spietari18/Elelabra/liitteet/ad-muunnos/ad-muunnos.jpg

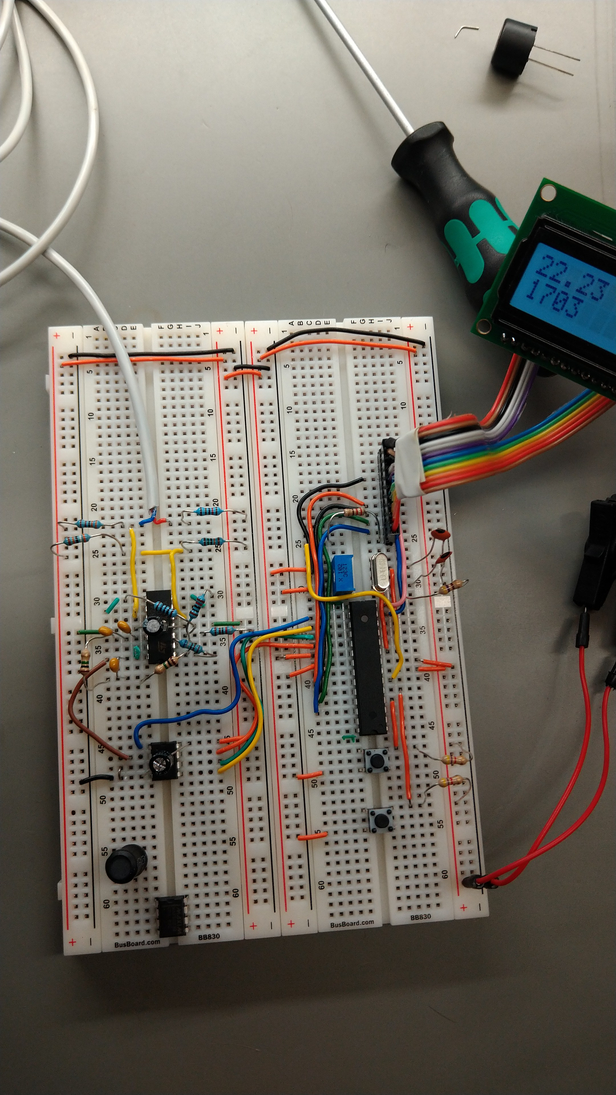
liitteet/ad-muunnos/ad-muunnos.jpg
