spietari18/Elelabra/README.md

## BL50A0503 - Elektroniikan laboratoriotyöt 1
