spietari18/Elelabra/liitteet/README.md

# Liitteet
## Mikrokontrollerin Käyttöönotto
- `käyttöönotto.c`: Lähdekoodi.
- `käyttöönotto.mp4`: Video toiminnasta.
- `vahvistin_lasku.rtf`: Vahvistinkytkennän lasku.
## AD-Muunnos
- `ad-muunnos.jpg`: Kuva toiminnasta.
- [Lähdekoodi kuvaushetkellä.](https://github.com/spietari18/Elelabra/tree/b525ab2afac167e4a86e1861a309233f2171b914/arduino/src)
## Käyttöliittymä
- `käyttöliittymä.mp4`: Video toiminnasta.
- [Lähdekoodi kuvaushetkellä.](https://github.com/spietari18/Elelabra/tree/88761098de45f244a9950bb6323d316a39081532/arduino/src)
