spietari18/Elelabra/liitteet/käyttöönotto/vahvistin_lasku.rtf

Sisääntulojännite:

Anturin resistanssit minimi- ja maksimilämpötilassa (-50°C,+80°C):

Wheatstone sillan resistanssit:

Differentiaalivahvistimen (puskuroidut) tulojännitteet:

Käytännön maksimi- ja minimilähtö operaatiovahvistimelle:

Differentiaalivahvistimen lähtö:

Kaksi resistanssia tulee määritellä, jotta toiset kaksi voidaan ratkaista:

Nämä saadaan differentiaalivahvistimen kaavasta:

Resistansseiksi saadaan siis:

Hylätään negatiiviset ratkaisut. Etsityt resistanssit ovat siis:
