spietari18/Elelabra/kicad/flow_chart/flow_chart.png

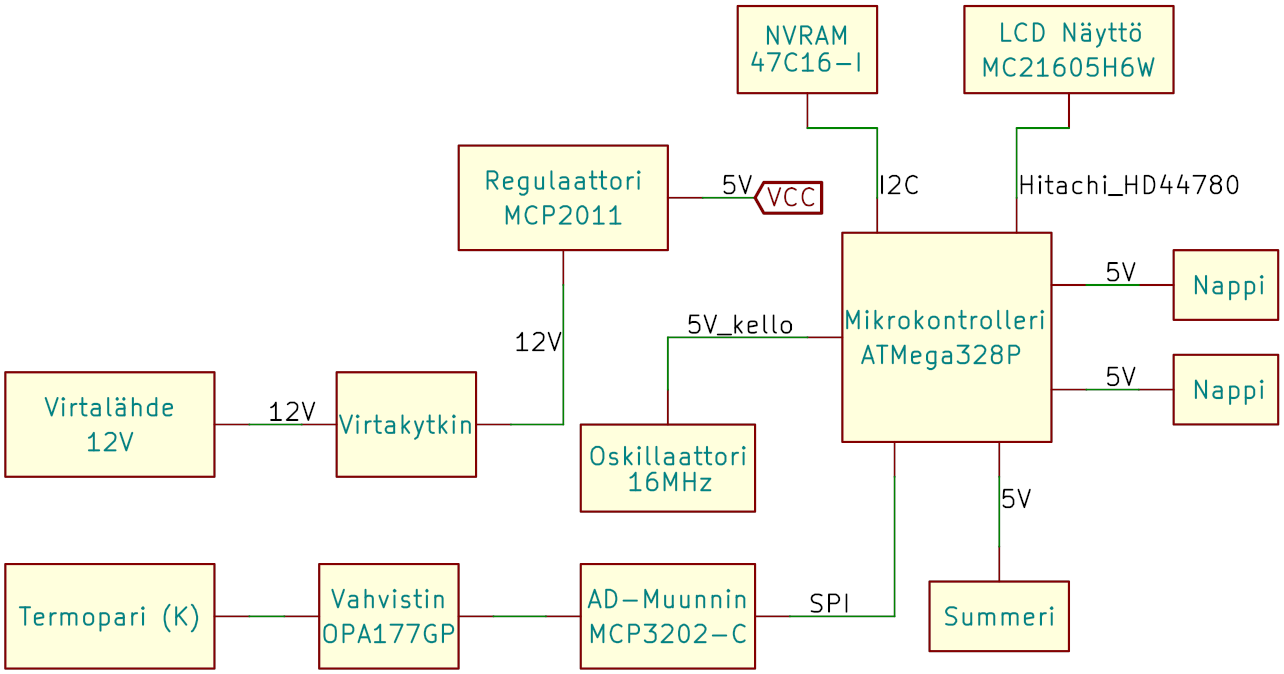
kicad/flow_chart/flow_chart.png
