spietari18/Elelabra/kicad/mikrokontrolleri/mikrokontrolleri.png

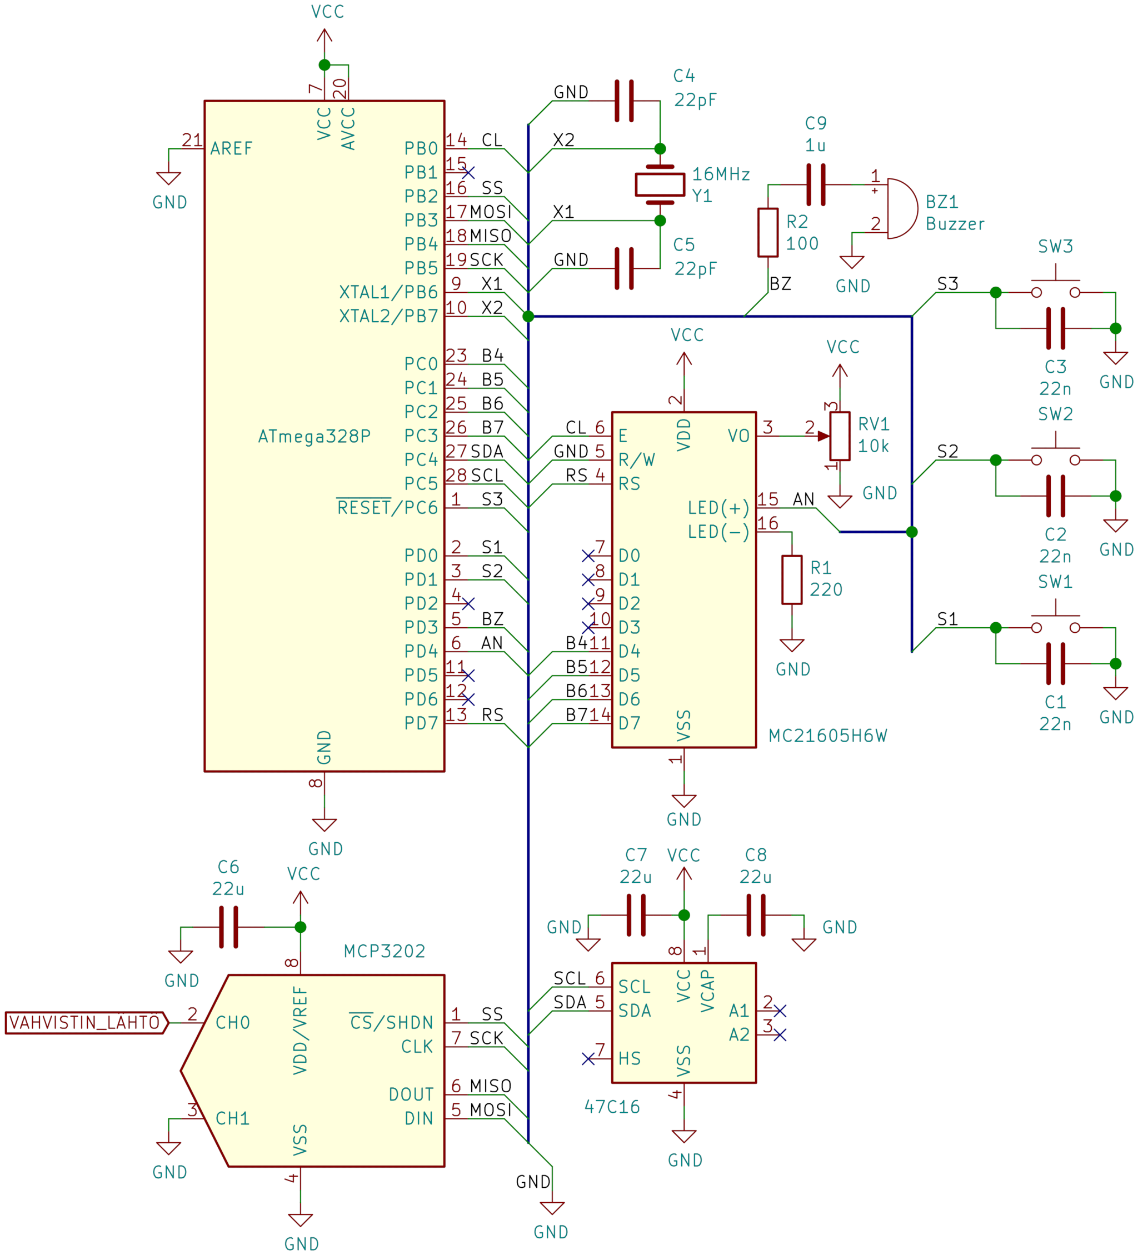
kicad/mikrokontrolleri/mikrokontrolleri.png
