spietari18/Elelabra/kicad/piirilevy/kuvat+cnc/back.png

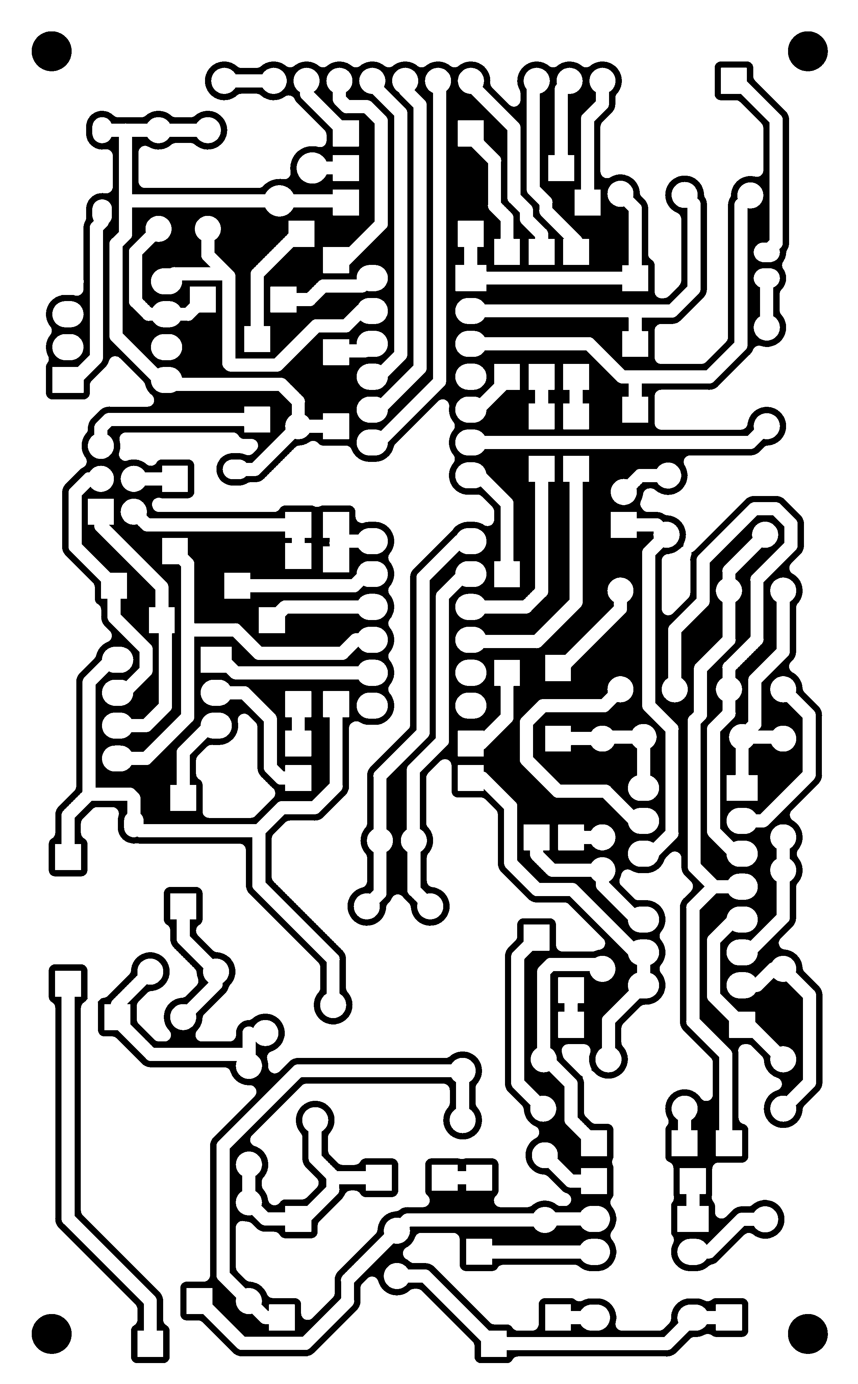
kicad/piirilevy/kuvat+cnc/back.png
