spietari18/Elelabra/kicad/piirilevy/kuvat+cnc/edges.png

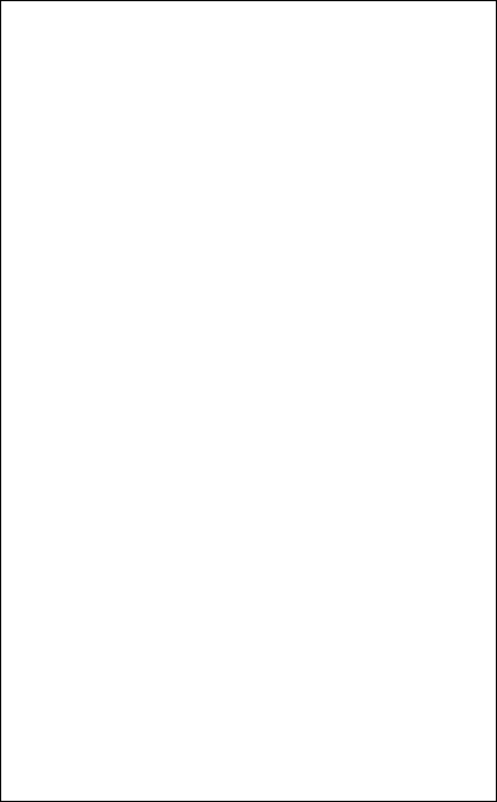
kicad/piirilevy/kuvat+cnc/edges.png
