spietari18/Elelabra/kicad/piirilevy/kuvat+cnc/holes.png

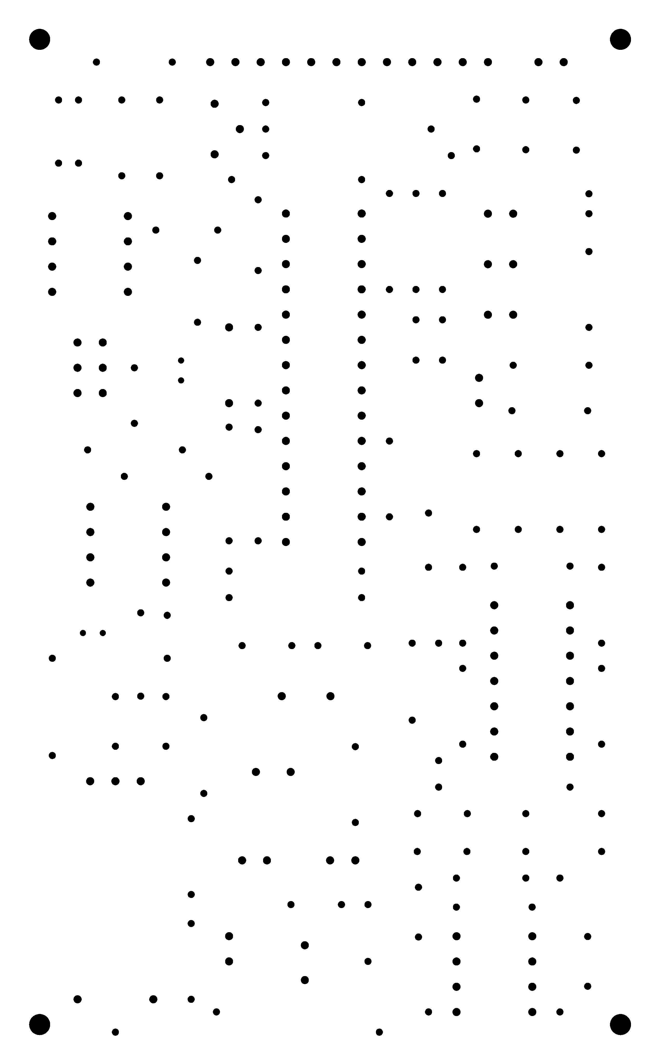
kicad/piirilevy/kuvat+cnc/holes.png
