spietari18/Elelabra/kicad/piirilevy/kuvat+cnc/render.png

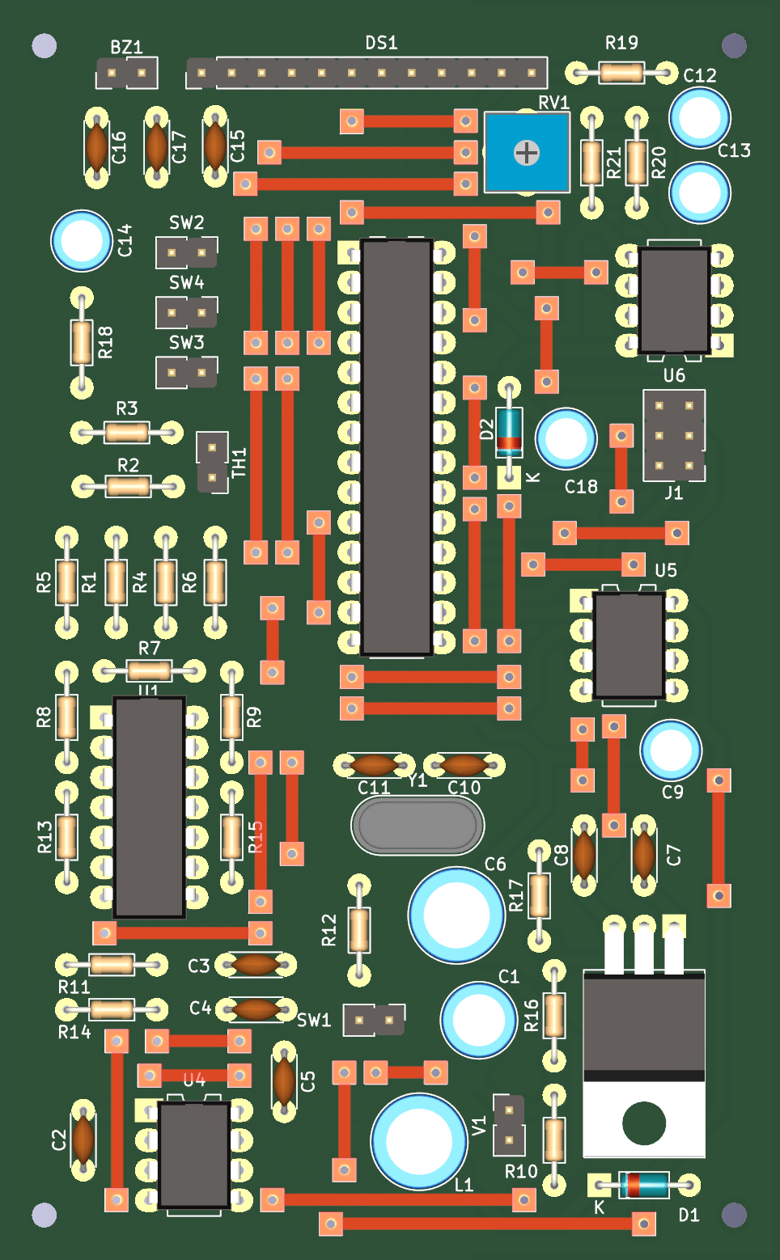
kicad/piirilevy/kuvat+cnc/render.png
