spietari18/Elelabra/kicad/regulaattori/regulaattori.png

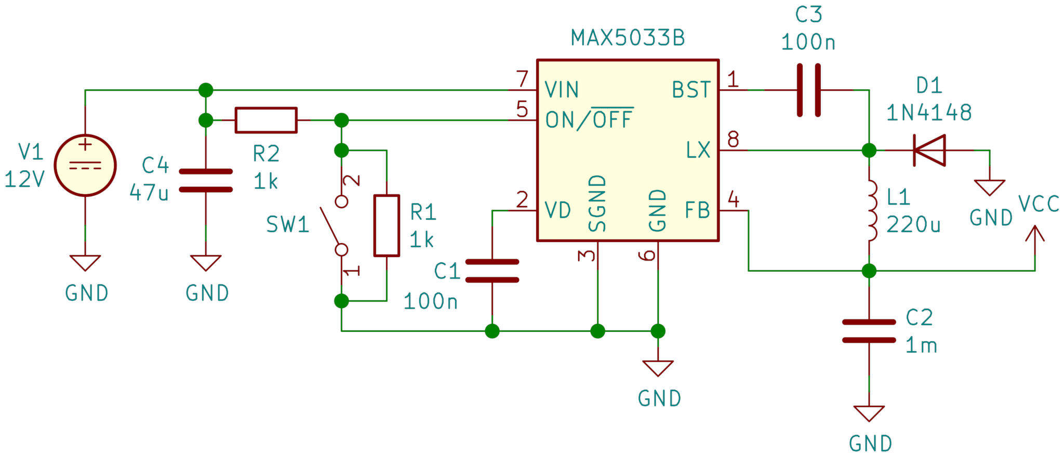
kicad/regulaattori/regulaattori.png
