spietari18/Elelabra/kicad/vahvistin/vahvistin.png

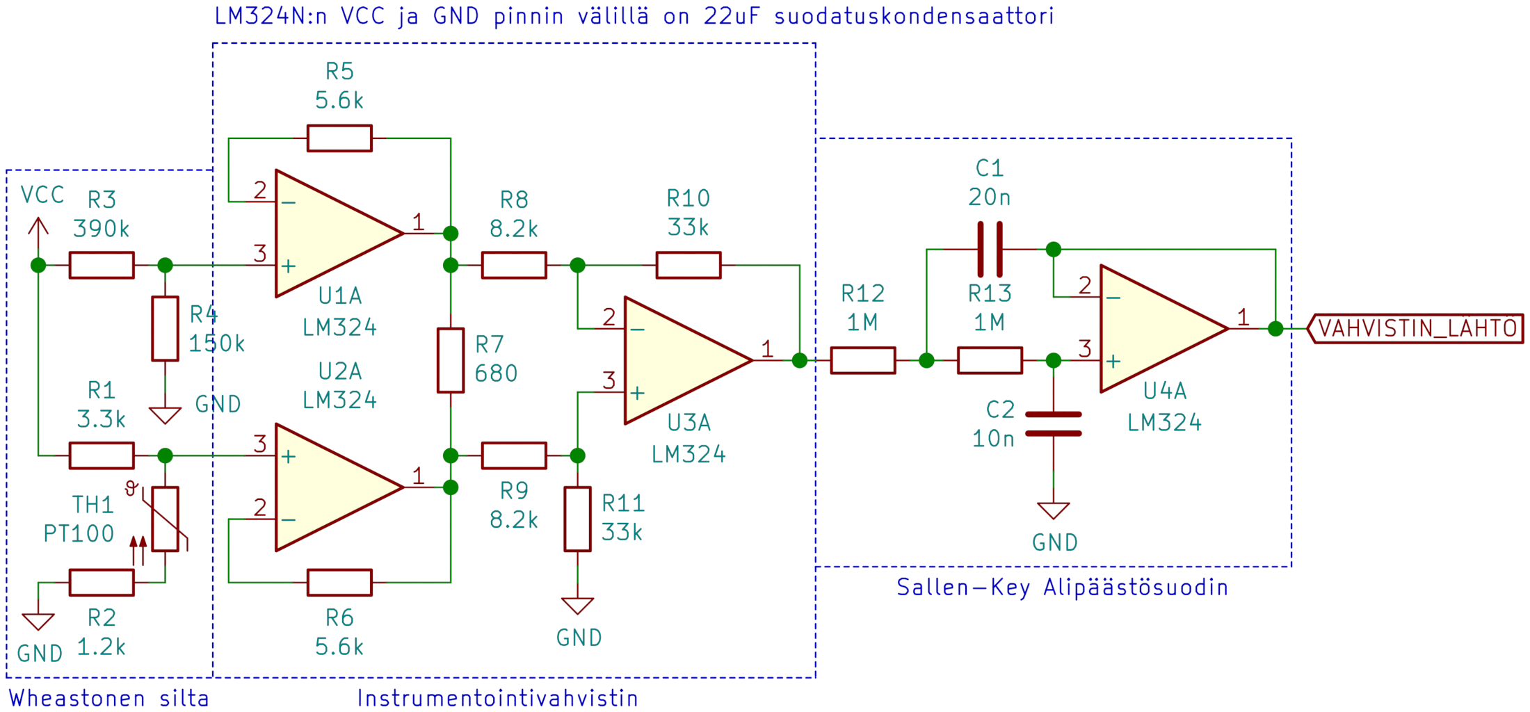
kicad/vahvistin/vahvistin.png
