spietari18/Elelabra/kicad/vahvistin/vahvistin_alpha.png

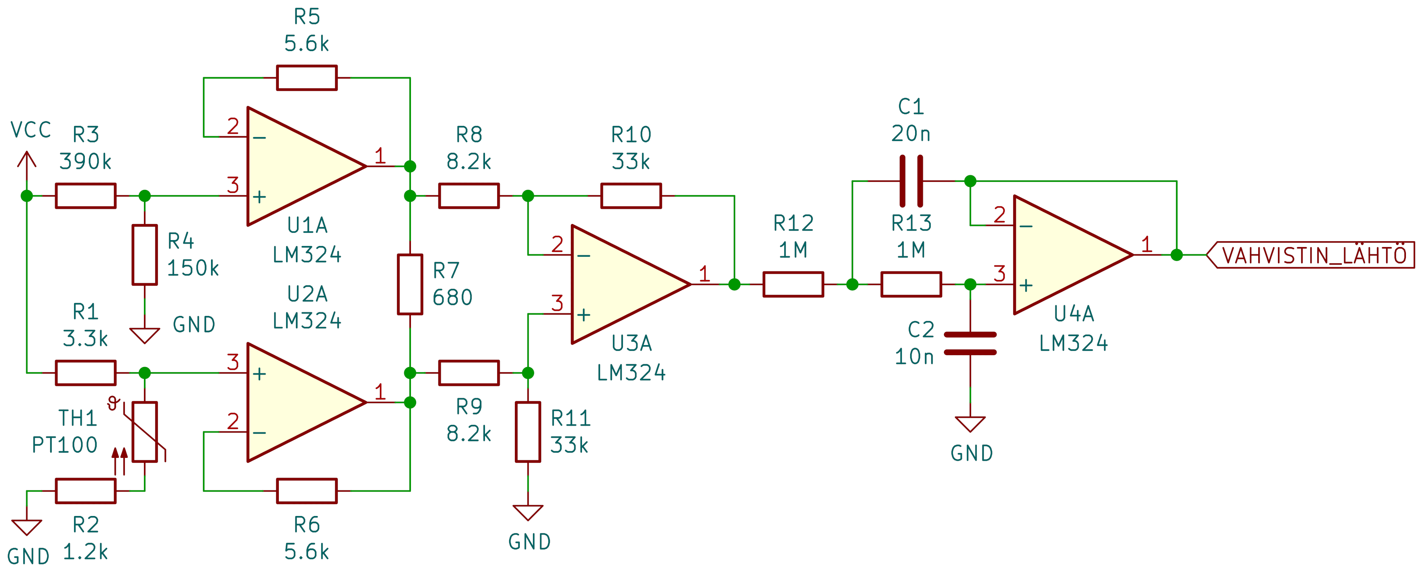
kicad/vahvistin/vahvistin_alpha.png
