spietari18/Elelabra/(list of files, drawings)

Other design files:
kicad/piirilevy/piirilevy.dsn
