spietari18/Elelabra/kicad/piirilevy/piirilevy.kicad_pcb

## KiCad design kicad/piirilevy/piirilevy.kicad_pcb (2022-03-16)

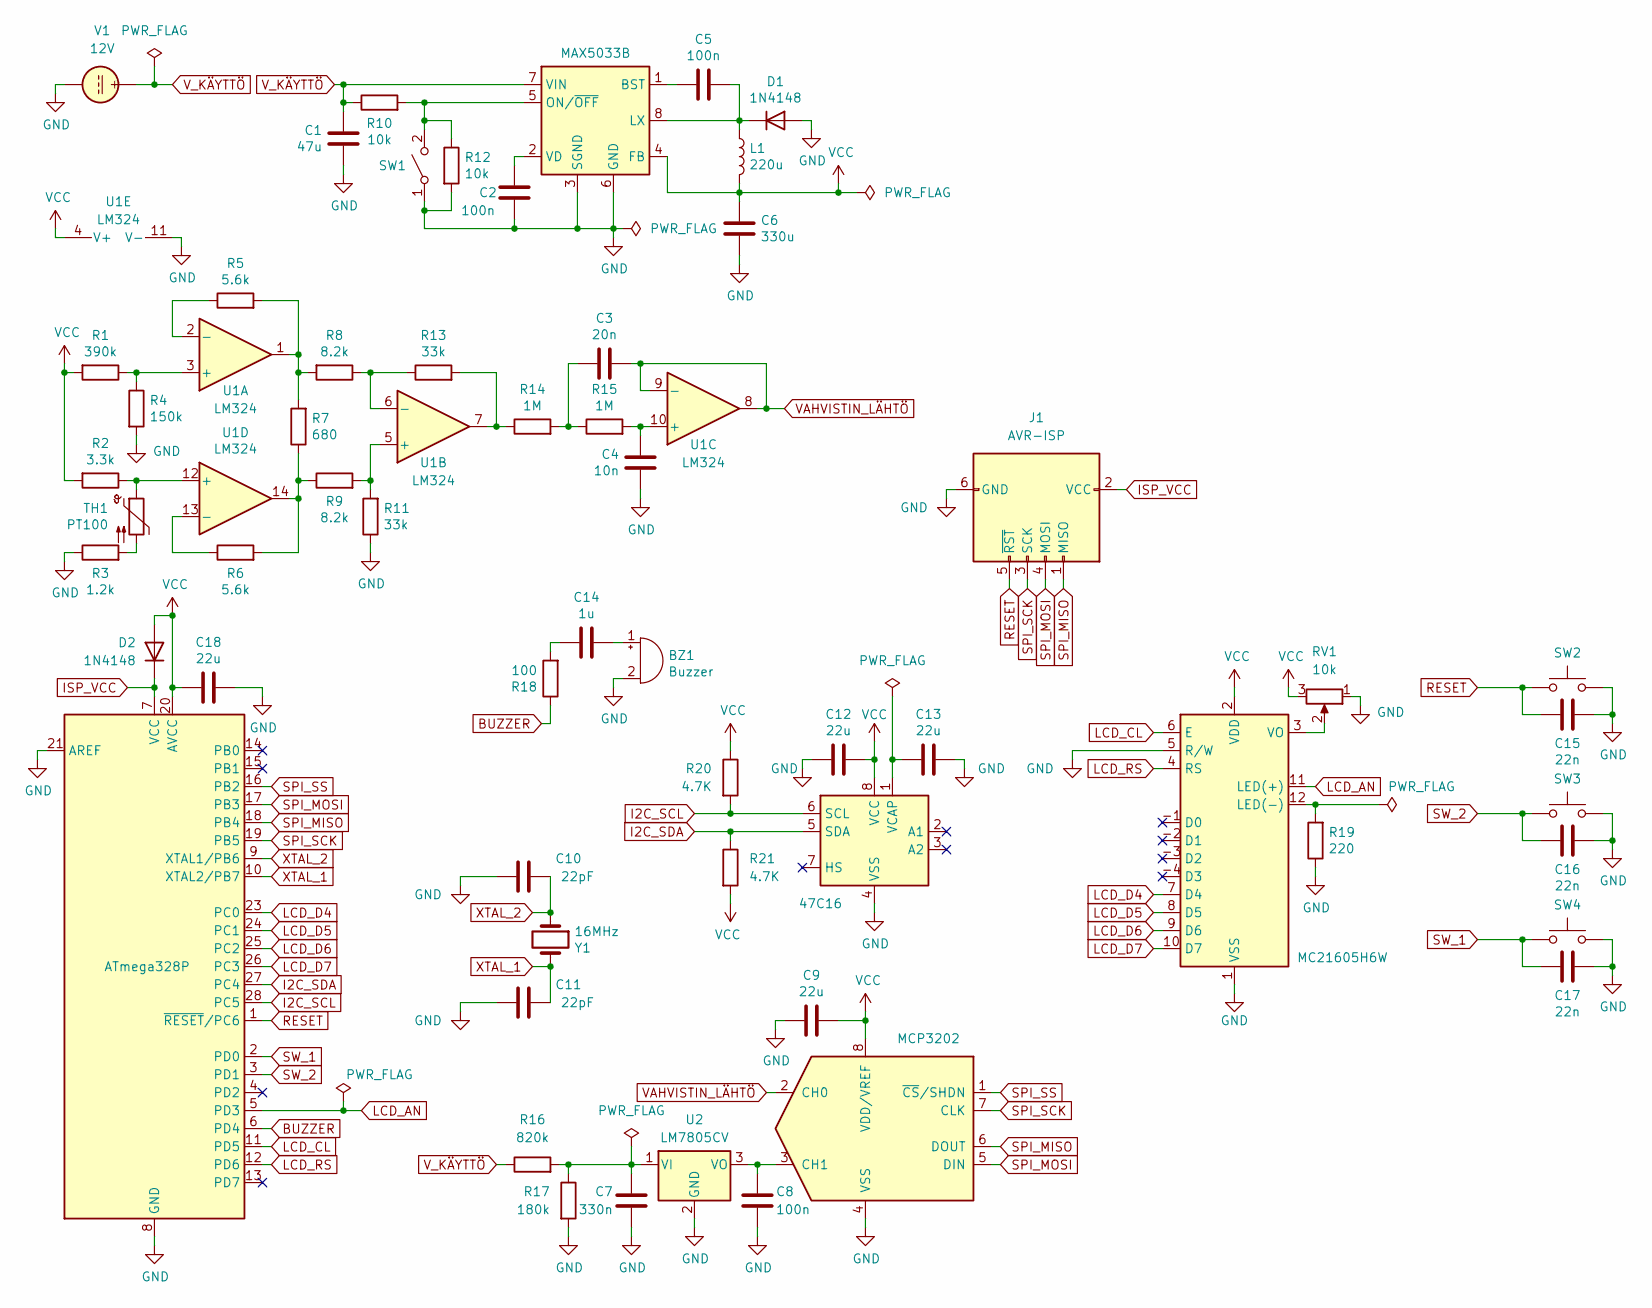
[picture p11: schematic piirilevy.kicad_sch]

Parts:
BZ1: Buzzer; PinHeader_1x02_P2.54mm_Vertical
C1: 47u; C_Radial_D6.3mm_H5.0mm_P2.50mm
C2, C5, C8: 100n; C_Disc_D4.3mm_W1.9mm_P5.00mm
C3: 20n; C_Disc_D4.3mm_W1.9mm_P5.00mm
C4: 10n; C_Disc_D4.3mm_W1.9mm_P5.00mm
C6: 330u; C_Radial_D8.0mm_H7.0mm_P3.50mm
C7: 330n; C_Disc_D4.3mm_W1.9mm_P5.00mm
C9, C18: 22u; C_Radial_D5.0mm_H7.0mm_P2.00mm
C10, C11: 22pF; C_Disc_D4.3mm_W1.9mm_P5.00mm
C12, C13: 22u; C_Radial_D5.0mm_H5.0mm_P2.00mm
C14: 1u; C_Radial_D5.0mm_H5.0mm_P2.00mm
C15, C16, C17: 22n; C_Disc_D4.3mm_W1.9mm_P5.00mm
D1, D2: 1N4148; D_DO-35_SOD27_P7.62mm_Horizontal
DS1: MC21605H6W; PinHeader_1x12_P2.54mm_Vertical
J1: AVR-ISP; PinHeader_2x03_P2.54mm_Vertical
L1: 220u; C_Radial_D8.0mm_H7.0mm_P3.50mm
R1: 390k; R_Axial_DIN0204_L3.6mm_D1.6mm_P7.62mm_Horizontal
R2: 3.3k; R_Axial_DIN0204_L3.6mm_D1.6mm_P7.62mm_Horizontal
R3: 1.2k; R_Axial_DIN0204_L3.6mm_D1.6mm_P7.62mm_Horizontal
R4: 150k; R_Axial_DIN0204_L3.6mm_D1.6mm_P7.62mm_Horizontal
R5, R6: 5.6k; R_Axial_DIN0204_L3.6mm_D1.6mm_P7.62mm_Horizontal
R7: 680; R_Axial_DIN0204_L3.6mm_D1.6mm_P7.62mm_Horizontal
R8, R9: 8.2k; R_Axial_DIN0204_L3.6mm_D1.6mm_P7.62mm_Horizontal
R10, R12: 10k; R_Axial_DIN0204_L3.6mm_D1.6mm_P7.62mm_Horizontal
R11, R13: 33k; R_Axial_DIN0204_L3.6mm_D1.6mm_P7.62mm_Horizontal
R14, R15: 1M; R_Axial_DIN0204_L3.6mm_D1.6mm_P7.62mm_Horizontal
R16: 820k; R_Axial_DIN0204_L3.6mm_D1.6mm_P7.62mm_Horizontal
R17: 180k; R_Axial_DIN0204_L3.6mm_D1.6mm_P7.62mm_Horizontal
R18: 100; R_Axial_DIN0204_L3.6mm_D1.6mm_P7.62mm_Horizontal
R19: 220; R_Axial_DIN0204_L3.6mm_D1.6mm_P7.62mm_Horizontal
R20, R21: 4.7K; R_Axial_DIN0204_L3.6mm_D1.6mm_P7.62mm_Horizontal
RV1: 10k; Potentiometer_Vishay_T73YP_Vertical
SW1: SW_SPST; PinHeader_1x02_P2.54mm_Vertical
SW2, SW3, SW4: SW_Push; PinHeader_1x02_P2.54mm_Vertical
TH1: PT100; PinHeader_1x02_P2.54mm_Vertical
U1: LM324; DIP-14_W7.62mm_LongPads
U2: LM7805CV; TO-220-3_Horizontal_TabDown
U3: ATmega328P; DIP-28_W7.62mm_LongPads
U4: MAX5033B; DIP-8_W7.62mm_LongPads
U5: MCP3202; DIP-8_W7.62mm_LongPads
U6: 47C16; DIP-8_W7.62mm_LongPads
V1: 12V; PinHeader_1x02_P2.54mm_Vertical
Y1: 16MHz; Crystal_HC18-U_Vertical

Connections:
BUZZER: R18.1, U3.6 (PD4)
GND: BZ1.2 (+), C1.1, C2.2, C4.2, C6.2, C7.2, C8.2, C9.2, C10.1, C11.2, C12.2, C13.1, C15.1, C16.1, C17.1, C18.1, D1.2 (A), DS1.1 (VSS), DS1.5 (R/W), J1.6 (GND), R3.1, R4.2, R11.1, R12.2, R17.2, R19.1, RV1.1, SW1.1 (A), SW2.2, SW3.2, SW4.2, U1.11 (V-), U2.2 (GND), U3.8 (GND), U3.21 (AREF), U3.22 (GND), U4.3 (SGND), U4.6 (GND), U5.4 (VSS), U6.4 (VSS), V1.2
I2C_SCL: R20.2, U3.28 (PC5), U6.6 (SCL)
I2C_SDA: R21.1, U3.27 (PC4), U6.5 (SDA)
ISP_VCC: D2.1 (K), J1.2 (VCC), U3.7 (VCC)
LCD_AN: DS1.11 (LED(+)), U3.5 (PD3)
LCD_CL: DS1.6 (E), U3.11 (PD5)
LCD_D4: DS1.7 (D4), U3.23 (PC0)
LCD_D5: DS1.8 (D5), U3.24 (PC1)
LCD_D6: DS1.9 (D6), U3.25 (PC2)
LCD_D7: DS1.10 (D7), U3.26 (PC3)
LCD_RS: DS1.4 (RS), U3.12 (PD6)
unnamed: BZ1.1 (-), C14.2
unnamed: C2.1, U4.2 (VD)
unnamed: C3.1, R14.2, R15.1
unnamed: C4.1, R15.2, U1.10 (+)
unnamed: C5.1, D1.1 (K), L1.1, U4.8 (LX)
unnamed: C5.2, U4.1 (BST)
unnamed: C7.1, R16.2, R17.1, U2.1 (VI)
unnamed: C8.1, U2.3 (VO), U5.3 (CH1)
unnamed: C13.2, U6.1 (VCAP)
unnamed: C14.1, R18.2
unnamed: DS1.3 (VO), RV1.2
unnamed: DS1.12 (LED(-)), R19.2
unnamed: R1.1, R4.1, U1.3 (+)
unnamed: R2.1, TH1.1, U1.12 (+)
unnamed: R3.2, TH1.2
unnamed: R5.1, U1.2 (-)
unnamed: R5.2, R7.2, R8.2, U1.1
unnamed: R6.1, U1.13 (-)
unnamed: R6.2, R7.1, R9.1, U1.14
unnamed: R10.2, R12.1, SW1.2 (B), U4.5 (ON/~OFF)
unnamed: R9.2, R11.2, U1.5 (+)
unnamed: R8.1, R13.1, U1.6 (-)
unnamed: R13.2, R14.1, U1.7
RESET: C15.2, J1.5 (~RST), SW2.1, U3.1 (~RESET/PC6)
SPI_MISO: J1.1 (MISO), U3.18 (PB4), U5.6 (DOUT)
SPI_MOSI: J1.4 (MOSI), U3.17 (PB3), U5.5 (DIN)
SPI_SCK: J1.3 (SCK), U3.19 (PB5), U5.7 (CLK)
SPI_SS: U3.16 (PB2), U5.1 (~CS/SHDN)
SW_1: C17.2, SW4.1, U3.2 (PD0)
SW_2: C16.2, SW3.1, U3.3 (PD1)
VAHVISTIN_LÄHTÖ: C3.2, U1.8, U1.9 (-), U5.2 (CH0)
VCC: C6.1, C9.1, C12.1, C18.2, D2.2 (A), DS1.2 (VDD), L1.2, R1.2, R2.2, R20.1, R21.2, RV1.3, U1.4 (V+), U3.20 (AVCC), U4.4 (FB), U5.8 (VDD/VREF), U6.8 (VCC)
V_KÄYTTÖ: C1.2, R10.1, R16.1, U4.7 (VIN), V1.1
XTAL_1: C11.1, U3.10 (XTAL2/PB7), Y1.2
XTAL_2: C10.2, U3.9 (XTAL1/PB6), Y1.1

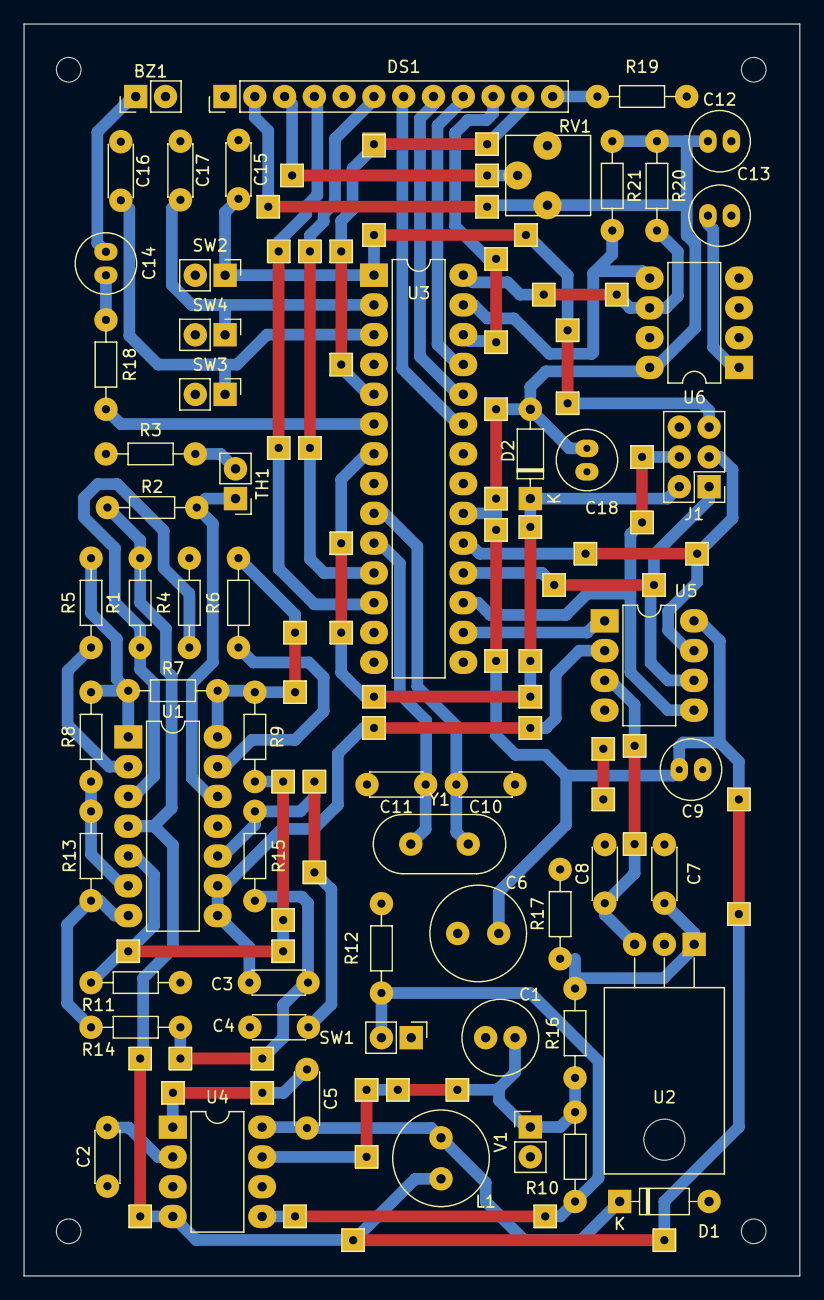
[picture p12: board piirilevy.kicad_pcb from above]

Board: 2 copper layers, 66.2 x 106.8 mm, 63 parts (0 on the bottom side), 47 nets.

Other parts of the board:
H1, H1#2, H3, H4: MountingHole_2.1mm
