spietari18/Elelabra/ohjelma/aux/button_simulation/keys.h

// awk '/#define KEY_/{tmp=substr($2, length($2)-2); if (!(length($2) == 7 && (tmp == "MAX" || tmp == "CNT"))) print "X(" $2 ")"}' /usr/include/linux/input-event-codes.h
X(KEY_RESERVED)
X(KEY_ESC)
X(KEY_1)
X(KEY_2)
X(KEY_3)
X(KEY_4)
X(KEY_5)
X(KEY_6)
X(KEY_7)
X(KEY_8)
X(KEY_9)
X(KEY_0)
X(KEY_MINUS)
X(KEY_EQUAL)
X(KEY_BACKSPACE)
X(KEY_TAB)
X(KEY_Q)
X(KEY_W)
X(KEY_E)
X(KEY_R)
X(KEY_T)
X(KEY_Y)
X(KEY_U)
X(KEY_I)
X(KEY_O)
X(KEY_P)
X(KEY_LEFTBRACE)
X(KEY_RIGHTBRACE)
X(KEY_ENTER)
X(KEY_LEFTCTRL)
X(KEY_A)
X(KEY_S)
X(KEY_D)
X(KEY_F)
X(KEY_G)
X(KEY_H)
X(KEY_J)
X(KEY_K)
X(KEY_L)
X(KEY_SEMICOLON)
X(KEY_APOSTROPHE)
X(KEY_GRAVE)
X(KEY_LEFTSHIFT)
X(KEY_BACKSLASH)
X(KEY_Z)
X(KEY_X)
X(KEY_C)
X(KEY_V)
X(KEY_B)
X(KEY_N)
X(KEY_M)
X(KEY_COMMA)
X(KEY_DOT)
X(KEY_SLASH)
X(KEY_RIGHTSHIFT)
X(KEY_KPASTERISK)
X(KEY_LEFTALT)
X(KEY_SPACE)
X(KEY_CAPSLOCK)
X(KEY_F1)
X(KEY_F2)
X(KEY_F3)
X(KEY_F4)
X(KEY_F5)
X(KEY_F6)
X(KEY_F7)
X(KEY_F8)
X(KEY_F9)
X(KEY_F10)
X(KEY_NUMLOCK)
X(KEY_SCROLLLOCK)
X(KEY_KP7)
X(KEY_KP8)
X(KEY_KP9)
X(KEY_KPMINUS)
X(KEY_KP4)
X(KEY_KP5)
X(KEY_KP6)
X(KEY_KPPLUS)
X(KEY_KP1)
X(KEY_KP2)
X(KEY_KP3)
X(KEY_KP0)
X(KEY_KPDOT)
X(KEY_ZENKAKUHANKAKU)
X(KEY_102ND)
X(KEY_F11)
X(KEY_F12)
X(KEY_RO)
X(KEY_KATAKANA)
X(KEY_HIRAGANA)
X(KEY_HENKAN)
X(KEY_KATAKANAHIRAGANA)
X(KEY_MUHENKAN)
X(KEY_KPJPCOMMA)
X(KEY_KPENTER)
X(KEY_RIGHTCTRL)
X(KEY_KPSLASH)
X(KEY_SYSRQ)
X(KEY_RIGHTALT)
X(KEY_LINEFEED)
X(KEY_HOME)
X(KEY_UP)
X(KEY_PAGEUP)
X(KEY_LEFT)
X(KEY_RIGHT)
X(KEY_END)
X(KEY_DOWN)
X(KEY_PAGEDOWN)
X(KEY_INSERT)
X(KEY_DELETE)
X(KEY_MACRO)
X(KEY_MUTE)
X(KEY_VOLUMEDOWN)
X(KEY_VOLUMEUP)
X(KEY_POWER)
X(KEY_KPEQUAL)
X(KEY_KPPLUSMINUS)
X(KEY_PAUSE)
X(KEY_SCALE)
X(KEY_KPCOMMA)
X(KEY_HANGEUL)
X(KEY_HANGUEL)
X(KEY_HANJA)
X(KEY_YEN)
X(KEY_LEFTMETA)
X(KEY_RIGHTMETA)
X(KEY_COMPOSE)
X(KEY_STOP)
X(KEY_AGAIN)
X(KEY_PROPS)
X(KEY_UNDO)
X(KEY_FRONT)
X(KEY_COPY)
X(KEY_OPEN)
X(KEY_PASTE)
X(KEY_FIND)
X(KEY_CUT)
X(KEY_HELP)
X(KEY_MENU)
X(KEY_CALC)
X(KEY_SETUP)
X(KEY_SLEEP)
X(KEY_WAKEUP)
X(KEY_FILE)
X(KEY_SENDFILE)
X(KEY_DELETEFILE)
X(KEY_XFER)
X(KEY_PROG1)
X(KEY_PROG2)
X(KEY_WWW)
X(KEY_MSDOS)
X(KEY_COFFEE)
X(KEY_SCREENLOCK)
X(KEY_ROTATE_DISPLAY)
X(KEY_DIRECTION)
X(KEY_CYCLEWINDOWS)
X(KEY_MAIL)
X(KEY_BOOKMARKS)
X(KEY_COMPUTER)
X(KEY_BACK)
X(KEY_FORWARD)
X(KEY_CLOSECD)
X(KEY_EJECTCD)
X(KEY_EJECTCLOSECD)
X(KEY_NEXTSONG)
X(KEY_PLAYPAUSE)
X(KEY_PREVIOUSSONG)
X(KEY_STOPCD)
X(KEY_RECORD)
X(KEY_REWIND)
X(KEY_PHONE)
X(KEY_ISO)
X(KEY_CONFIG)
X(KEY_HOMEPAGE)
X(KEY_REFRESH)
X(KEY_EXIT)
X(KEY_MOVE)
X(KEY_EDIT)
X(KEY_SCROLLUP)
X(KEY_SCROLLDOWN)
X(KEY_KPLEFTPAREN)
X(KEY_KPRIGHTPAREN)
X(KEY_NEW)
X(KEY_REDO)
X(KEY_F13)
X(KEY_F14)
X(KEY_F15)
X(KEY_F16)
X(KEY_F17)
X(KEY_F18)
X(KEY_F19)
X(KEY_F20)
X(KEY_F21)
X(KEY_F22)
X(KEY_F23)
X(KEY_F24)
X(KEY_PLAYCD)
X(KEY_PAUSECD)
X(KEY_PROG3)
X(KEY_PROG4)
X(KEY_DASHBOARD)
X(KEY_SUSPEND)
X(KEY_CLOSE)
X(KEY_PLAY)
X(KEY_FASTFORWARD)
X(KEY_BASSBOOST)
X(KEY_PRINT)
X(KEY_HP)
X(KEY_CAMERA)
X(KEY_SOUND)
X(KEY_QUESTION)
X(KEY_EMAIL)
X(KEY_CHAT)
X(KEY_SEARCH)
X(KEY_CONNECT)
X(KEY_FINANCE)
X(KEY_SPORT)
X(KEY_SHOP)
X(KEY_ALTERASE)
X(KEY_CANCEL)
X(KEY_BRIGHTNESSDOWN)
X(KEY_BRIGHTNESSUP)
X(KEY_MEDIA)
X(KEY_SWITCHVIDEOMODE)
X(KEY_KBDILLUMTOGGLE)
X(KEY_KBDILLUMDOWN)
X(KEY_KBDILLUMUP)
X(KEY_SEND)
X(KEY_REPLY)
X(KEY_FORWARDMAIL)
X(KEY_SAVE)
X(KEY_DOCUMENTS)
X(KEY_BATTERY)
X(KEY_BLUETOOTH)
X(KEY_WLAN)
X(KEY_UWB)
X(KEY_UNKNOWN)
X(KEY_VIDEO_NEXT)
X(KEY_VIDEO_PREV)
X(KEY_BRIGHTNESS_CYCLE)
X(KEY_BRIGHTNESS_AUTO)
X(KEY_BRIGHTNESS_ZERO)
X(KEY_DISPLAY_OFF)
X(KEY_WWAN)
X(KEY_WIMAX)
X(KEY_RFKILL)
X(KEY_MICMUTE)
X(KEY_OK)
X(KEY_SELECT)
X(KEY_GOTO)
X(KEY_CLEAR)
X(KEY_POWER2)
X(KEY_OPTION)
X(KEY_INFO)
X(KEY_TIME)
X(KEY_VENDOR)
X(KEY_ARCHIVE)
X(KEY_PROGRAM)
X(KEY_CHANNEL)
X(KEY_FAVORITES)
X(KEY_EPG)
X(KEY_PVR)
X(KEY_MHP)
X(KEY_LANGUAGE)
X(KEY_TITLE)
X(KEY_SUBTITLE)
X(KEY_ANGLE)
X(KEY_FULL_SCREEN)
X(KEY_ZOOM)
X(KEY_MODE)
X(KEY_KEYBOARD)
X(KEY_ASPECT_RATIO)
X(KEY_SCREEN)
X(KEY_PC)
X(KEY_TV)
X(KEY_TV2)
X(KEY_VCR)
X(KEY_VCR2)
X(KEY_SAT)
X(KEY_SAT2)
X(KEY_CD)
X(KEY_TAPE)
X(KEY_RADIO)
X(KEY_TUNER)
X(KEY_PLAYER)
X(KEY_TEXT)
X(KEY_DVD)
X(KEY_AUX)
X(KEY_MP3)
X(KEY_AUDIO)
X(KEY_VIDEO)
X(KEY_DIRECTORY)
X(KEY_LIST)
X(KEY_MEMO)
X(KEY_CALENDAR)
X(KEY_RED)
X(KEY_GREEN)
X(KEY_YELLOW)
X(KEY_BLUE)
X(KEY_CHANNELUP)
X(KEY_CHANNELDOWN)
X(KEY_FIRST)
X(KEY_LAST)
X(KEY_AB)
X(KEY_NEXT)
X(KEY_RESTART)
X(KEY_SLOW)
X(KEY_SHUFFLE)
X(KEY_BREAK)
X(KEY_PREVIOUS)
X(KEY_DIGITS)
X(KEY_TEEN)
X(KEY_TWEN)
X(KEY_VIDEOPHONE)
X(KEY_GAMES)
X(KEY_ZOOMIN)
X(KEY_ZOOMOUT)
X(KEY_ZOOMRESET)
X(KEY_WORDPROCESSOR)
X(KEY_EDITOR)
X(KEY_SPREADSHEET)
X(KEY_GRAPHICSEDITOR)
X(KEY_PRESENTATION)
X(KEY_DATABASE)
X(KEY_NEWS)
X(KEY_VOICEMAIL)
X(KEY_ADDRESSBOOK)
X(KEY_MESSENGER)
X(KEY_DISPLAYTOGGLE)
X(KEY_BRIGHTNESS_TOGGLE)
X(KEY_SPELLCHECK)
X(KEY_LOGOFF)
X(KEY_DOLLAR)
X(KEY_EURO)
X(KEY_FRAMEBACK)
X(KEY_FRAMEFORWARD)
X(KEY_CONTEXT_MENU)
X(KEY_MEDIA_REPEAT)
X(KEY_10CHANNELSUP)
X(KEY_10CHANNELSDOWN)
X(KEY_IMAGES)
X(KEY_NOTIFICATION_CENTER)
X(KEY_PICKUP_PHONE)
X(KEY_HANGUP_PHONE)
X(KEY_DEL_EOL)
X(KEY_DEL_EOS)
X(KEY_INS_LINE)
X(KEY_DEL_LINE)
X(KEY_FN)
X(KEY_FN_ESC)
X(KEY_FN_F1)
X(KEY_FN_F2)
X(KEY_FN_F3)
X(KEY_FN_F4)
X(KEY_FN_F5)
X(KEY_FN_F6)
X(KEY_FN_F7)
X(KEY_FN_F8)
X(KEY_FN_F9)
X(KEY_FN_F10)
X(KEY_FN_F11)
X(KEY_FN_F12)
X(KEY_FN_1)
X(KEY_FN_2)
X(KEY_FN_D)
X(KEY_FN_E)
X(KEY_FN_F)
X(KEY_FN_S)
X(KEY_FN_B)
X(KEY_FN_RIGHT_SHIFT)
X(KEY_BRL_DOT1)
X(KEY_BRL_DOT2)
X(KEY_BRL_DOT3)
X(KEY_BRL_DOT4)
X(KEY_BRL_DOT5)
X(KEY_BRL_DOT6)
X(KEY_BRL_DOT7)
X(KEY_BRL_DOT8)
X(KEY_BRL_DOT9)
X(KEY_BRL_DOT10)
X(KEY_NUMERIC_0)
X(KEY_NUMERIC_1)
X(KEY_NUMERIC_2)
X(KEY_NUMERIC_3)
X(KEY_NUMERIC_4)
X(KEY_NUMERIC_5)
X(KEY_NUMERIC_6)
X(KEY_NUMERIC_7)
X(KEY_NUMERIC_8)
X(KEY_NUMERIC_9)
X(KEY_NUMERIC_STAR)
X(KEY_NUMERIC_POUND)
X(KEY_NUMERIC_A)
X(KEY_NUMERIC_B)
X(KEY_NUMERIC_C)
X(KEY_NUMERIC_D)
X(KEY_CAMERA_FOCUS)
X(KEY_WPS_BUTTON)
X(KEY_TOUCHPAD_TOGGLE)
X(KEY_TOUCHPAD_ON)
X(KEY_TOUCHPAD_OFF)
X(KEY_CAMERA_ZOOMIN)
X(KEY_CAMERA_ZOOMOUT)
X(KEY_CAMERA_UP)
X(KEY_CAMERA_DOWN)
X(KEY_CAMERA_LEFT)
X(KEY_CAMERA_RIGHT)
X(KEY_ATTENDANT_ON)
X(KEY_ATTENDANT_OFF)
X(KEY_ATTENDANT_TOGGLE)
X(KEY_LIGHTS_TOGGLE)
X(KEY_ALS_TOGGLE)
X(KEY_ROTATE_LOCK_TOGGLE)
X(KEY_BUTTONCONFIG)
X(KEY_TASKMANAGER)
X(KEY_JOURNAL)
X(KEY_CONTROLPANEL)
X(KEY_APPSELECT)
X(KEY_SCREENSAVER)
X(KEY_VOICECOMMAND)
X(KEY_ASSISTANT)
X(KEY_KBD_LAYOUT_NEXT)
X(KEY_BRIGHTNESS_MIN)
X(KEY_BRIGHTNESS_MAX)
X(KEY_KBDINPUTASSIST_PREV)
X(KEY_KBDINPUTASSIST_NEXT)
X(KEY_KBDINPUTASSIST_PREVGROUP)
X(KEY_KBDINPUTASSIST_NEXTGROUP)
X(KEY_KBDINPUTASSIST_ACCEPT)
X(KEY_KBDINPUTASSIST_CANCEL)
X(KEY_RIGHT_UP)
X(KEY_RIGHT_DOWN)
X(KEY_LEFT_UP)
X(KEY_LEFT_DOWN)
X(KEY_ROOT_MENU)
X(KEY_MEDIA_TOP_MENU)
X(KEY_NUMERIC_11)
X(KEY_NUMERIC_12)
X(KEY_AUDIO_DESC)
X(KEY_3D_MODE)
X(KEY_NEXT_FAVORITE)
X(KEY_STOP_RECORD)
X(KEY_PAUSE_RECORD)
X(KEY_VOD)
X(KEY_UNMUTE)
X(KEY_FASTREVERSE)
X(KEY_SLOWREVERSE)
X(KEY_DATA)
X(KEY_ONSCREEN_KEYBOARD)
X(KEY_PRIVACY_SCREEN_TOGGLE)
X(KEY_SELECTIVE_SCREENSHOT)
X(KEY_MACRO1)
X(KEY_MACRO2)
X(KEY_MACRO3)
X(KEY_MACRO4)
X(KEY_MACRO5)
X(KEY_MACRO6)
X(KEY_MACRO7)
X(KEY_MACRO8)
X(KEY_MACRO9)
X(KEY_MACRO10)
X(KEY_MACRO11)
X(KEY_MACRO12)
X(KEY_MACRO13)
X(KEY_MACRO14)
X(KEY_MACRO15)
X(KEY_MACRO16)
X(KEY_MACRO17)
X(KEY_MACRO18)
X(KEY_MACRO19)
X(KEY_MACRO20)
X(KEY_MACRO21)
X(KEY_MACRO22)
X(KEY_MACRO23)
X(KEY_MACRO24)
X(KEY_MACRO25)
X(KEY_MACRO26)
X(KEY_MACRO27)
X(KEY_MACRO28)
X(KEY_MACRO29)
X(KEY_MACRO30)
X(KEY_MACRO_RECORD_START)
X(KEY_MACRO_RECORD_STOP)
X(KEY_MACRO_PRESET_CYCLE)
X(KEY_MACRO_PRESET1)
X(KEY_MACRO_PRESET2)
X(KEY_MACRO_PRESET3)
X(KEY_KBD_LCD_MENU1)
X(KEY_KBD_LCD_MENU2)
X(KEY_KBD_LCD_MENU3)
X(KEY_KBD_LCD_MENU4)
X(KEY_KBD_LCD_MENU5)
X(KEY_MIN_INTERESTING)
