spietari18/Elelabra/(commit log)

2021-12-15 Poista riippuvuus Arduino kirjastoista kokonaan.
2021-12-21 KiCad tiedostot.
    [flow_chart.sch, mikrokontrolleri.sch, regulaattori.sch, vahvistin.sch]
2022-01-19 Muutokset kaavioihin.
    [mikrokontrolleri.sch, vahvistin.sch]
2022-01-27 Piirilevylle KiCad projekti.
    [mikrokontrolleri.kicad_sch, piirilevy.kicad_pcb, piirilevy.kicad_sch]
2022-01-27 Muutokset piirilevyyn.
    [piirilevy.kicad_pcb, piirilevy.kicad_sch]
2022-01-27 Testausreititys piirilevylle.
    [piirilevy.dsn, piirilevy.kicad_pcb, piirilevy_reititetty.kicad_pcb]
2022-02-02 kicad muutokset
    [piirilevy.dsn, piirilevy.kicad_pcb, piirilevy.kicad_sch, piirilevy_reititetty.kicad_pcb]
2022-02-03 Torstain muutokset.
    [piirilevy.dsn, piirilevy.kicad_pcb, piirilevy.kicad_sch]
2022-02-04 Korjaukset piirilevyyn + CNC tiedostot ja kuvat.
    [piirilevy.dsn, piirilevy.kicad_pcb, piirilevy.kicad_sch]
2022-02-04 3D kuva piirilevystä.
    [piirilevy.kicad_pcb]
2022-02-16 Yksipuoleinen piirilevy.
    [piirilevy.kicad_pcb]
2022-03-16 Pientä koodin siivousta, datapisteiden katselu CALIBRATION valikkoon ja muistin testaus OPTIONS valikkoon.
2022-03-16 Korjaa lämpötilalukeman päivitys CALIBRATION valikossa.
